Multiflexmeter/Module-V4-Pressure/docs/P22296-2-HWDOC-1.6 (Production RS485).PDF

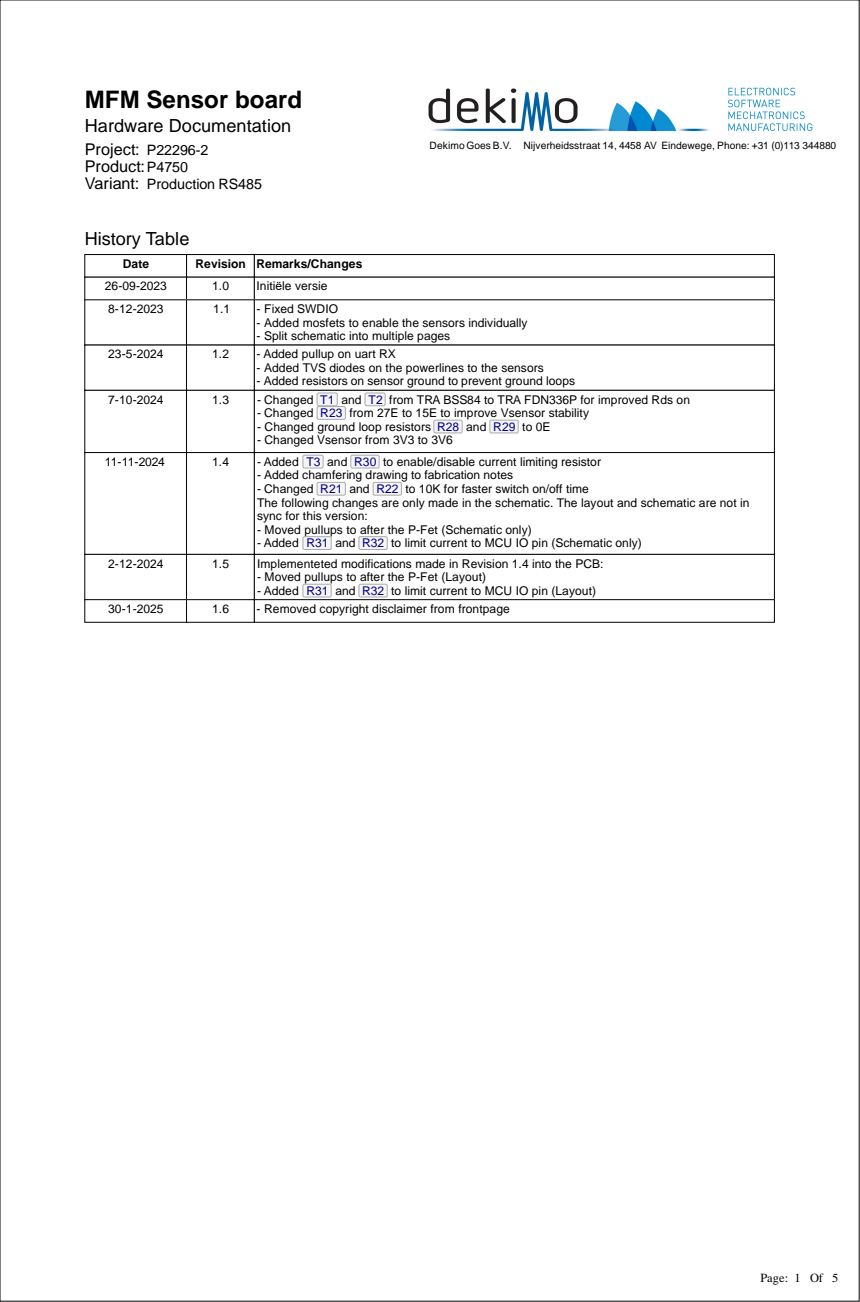
[picture p1: page 1]

Date | Revision | Remarks/Changes

26-09-2023 | 1.0 | Initiële versie

8-12-2023 | 1.1 | - Fixed SWDIO - Added mosfets to enable the sensors individually - Split schematic into multiple pages

23-5-2024 | 1.2 | - Added pullup on uart RX - Added TVS diodes on the powerlines to the sensors - Added resistors on sensor ground to prevent ground loops

7-10-2024 | 1.3 | - Changed T1 and T2 from TRA BSS84 to TRA FDN336P for improved Rds on - Changed R23 from 27E to 15E to improve Vsensor stability - Changed ground loop resistors R28 and R29 to 0E - Changed Vsensor from 3V3 to 3V6

11-11-2024 | 1.4 | - Added T3 and R30 to enable/disable current limiting resistor - Added chamfering drawing to fabrication notes - Changed R21 and R22 to 10K for faster switch on/off time The following changes are only made in the schematic. The layout and schematic are not in sync for this version: - Moved pullups to after the P-Fet (Schematic only) - Added R31 and R32 to limit current to MCU IO pin (Schematic only)

2-12-2024 | 1.5 | Implementeted modifications made in Revision 1.4 into the PCB: - Moved pullups to after the P-Fet (Layout) - Added R31 and R32 to limit current to MCU IO pin (Layout)

30-1-2025 | 1.6 | - Removed copyright disclaimer from frontpage

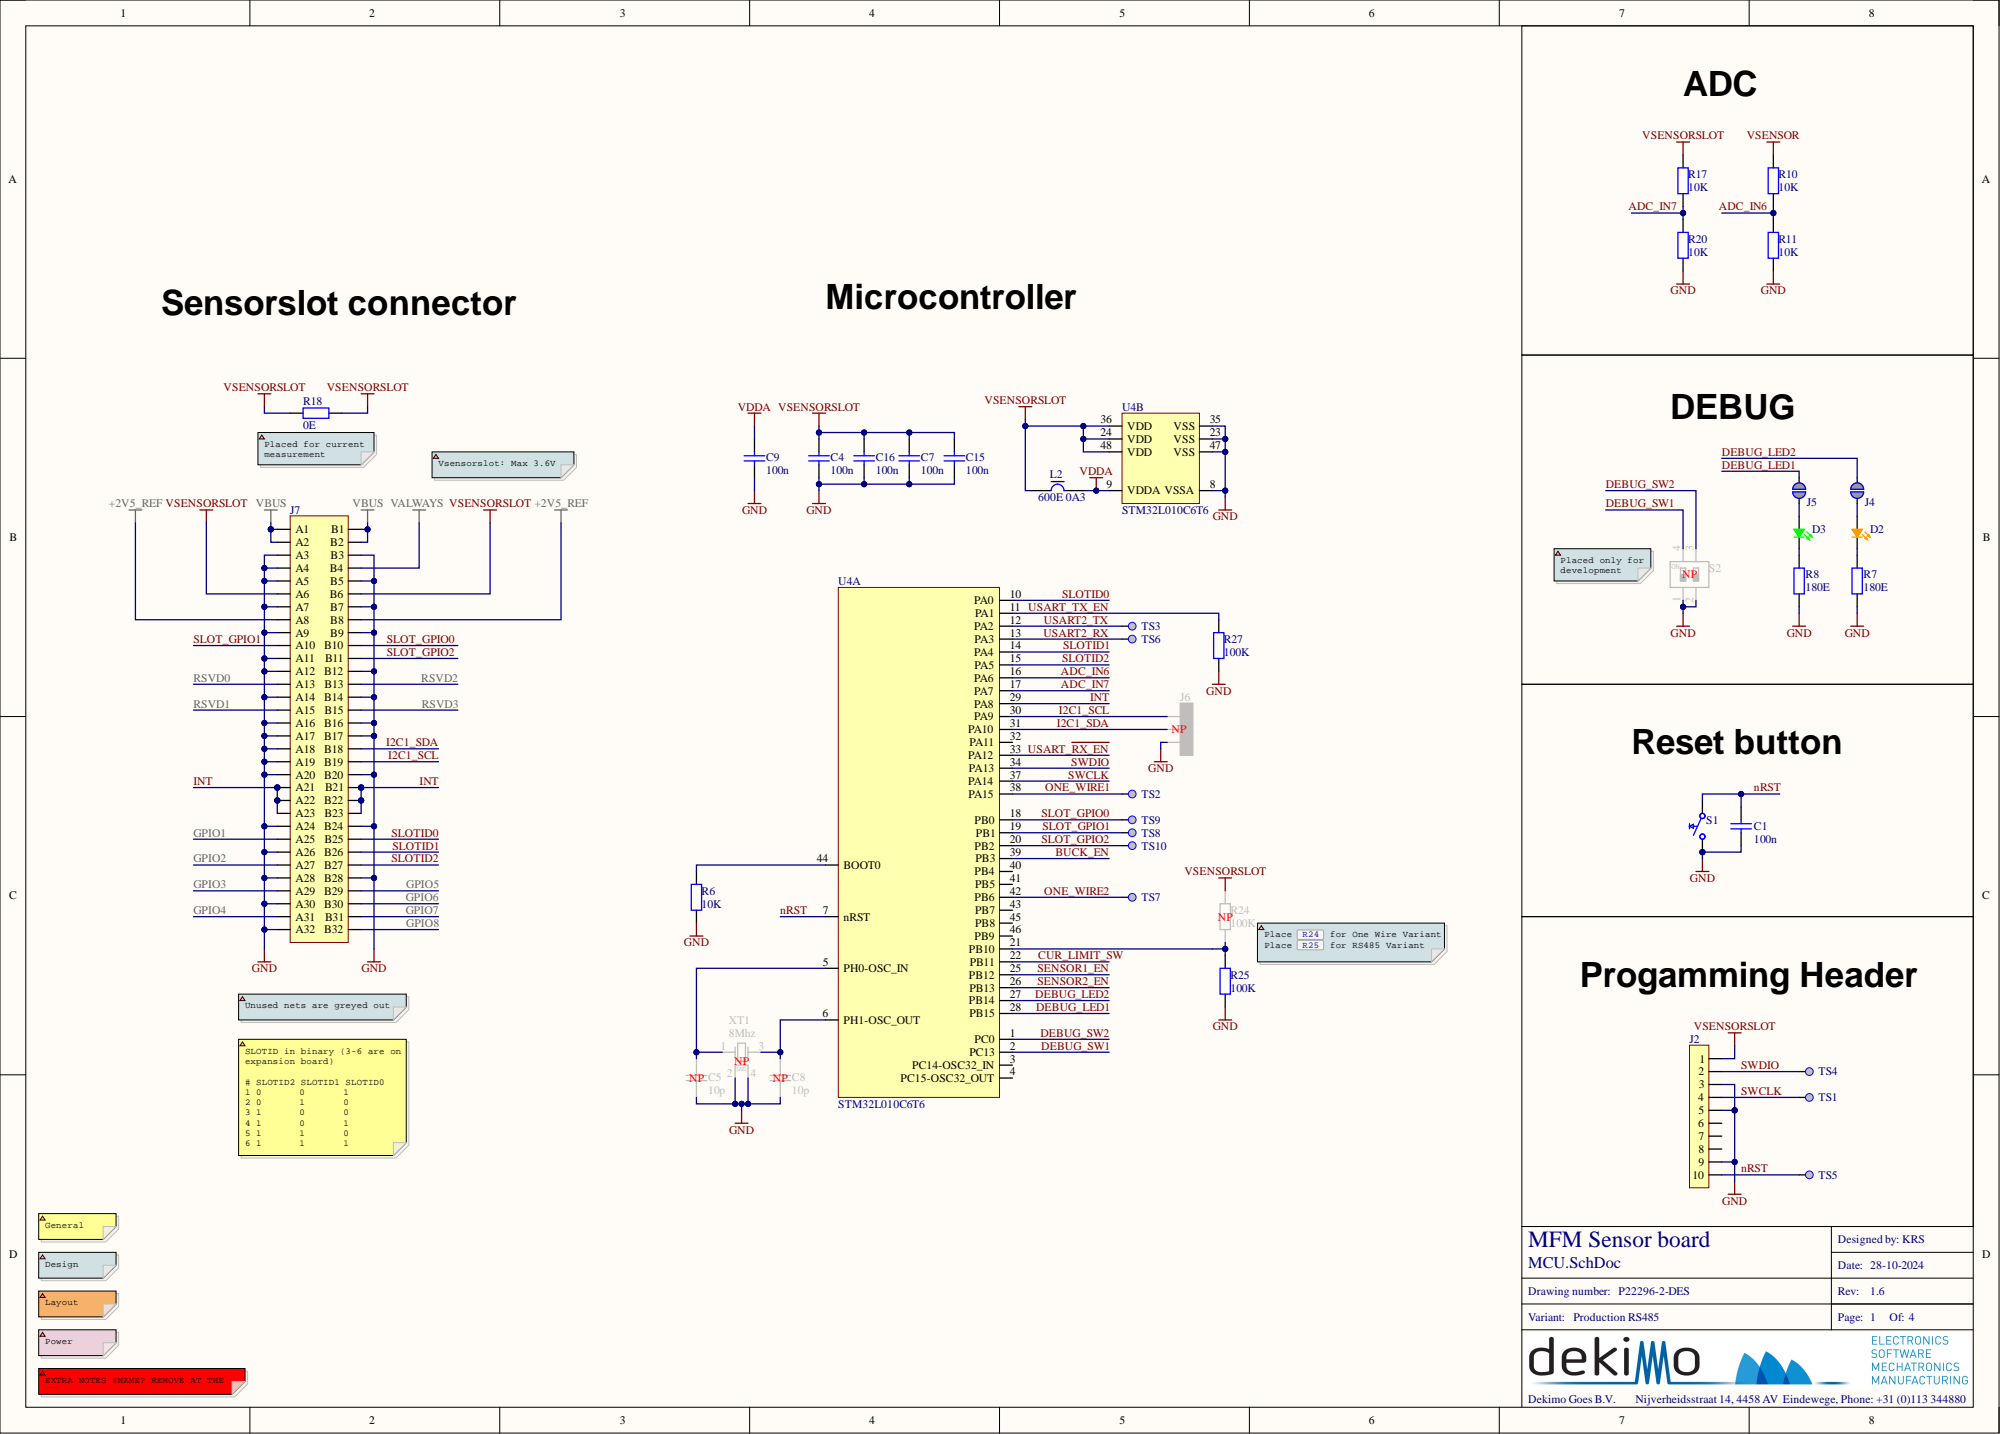
[picture p2: page 2]

2 | 4 | 2 3
4 | 8 | 4 7

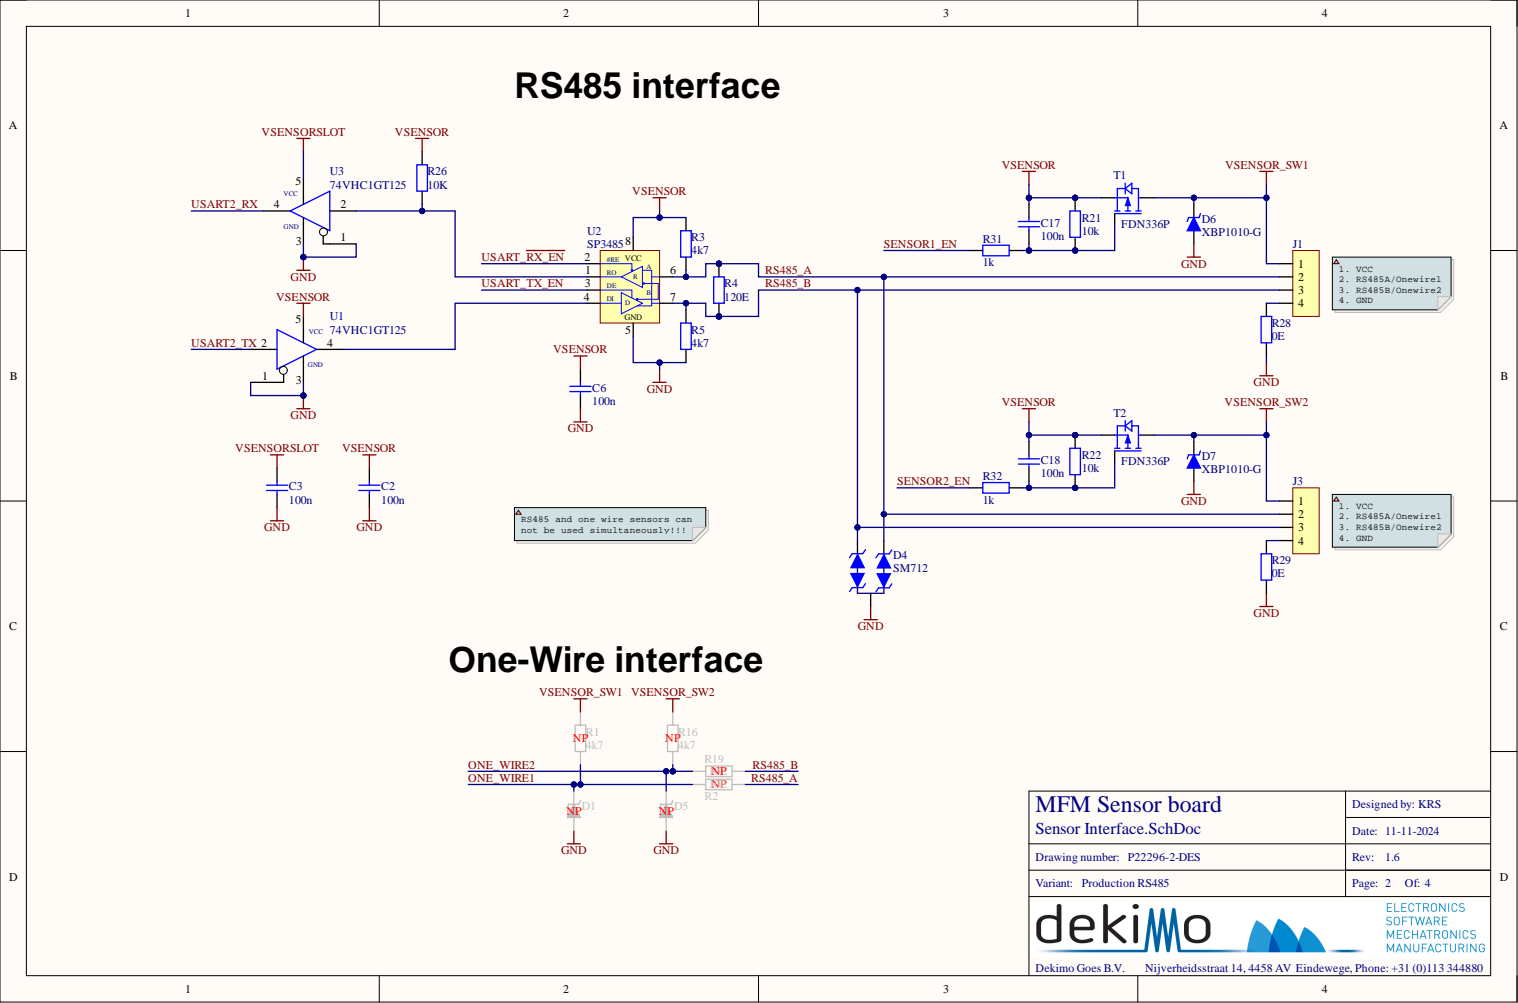
[picture p3: page 3]

RS4 8 5 _A
RS4 8 5 _B

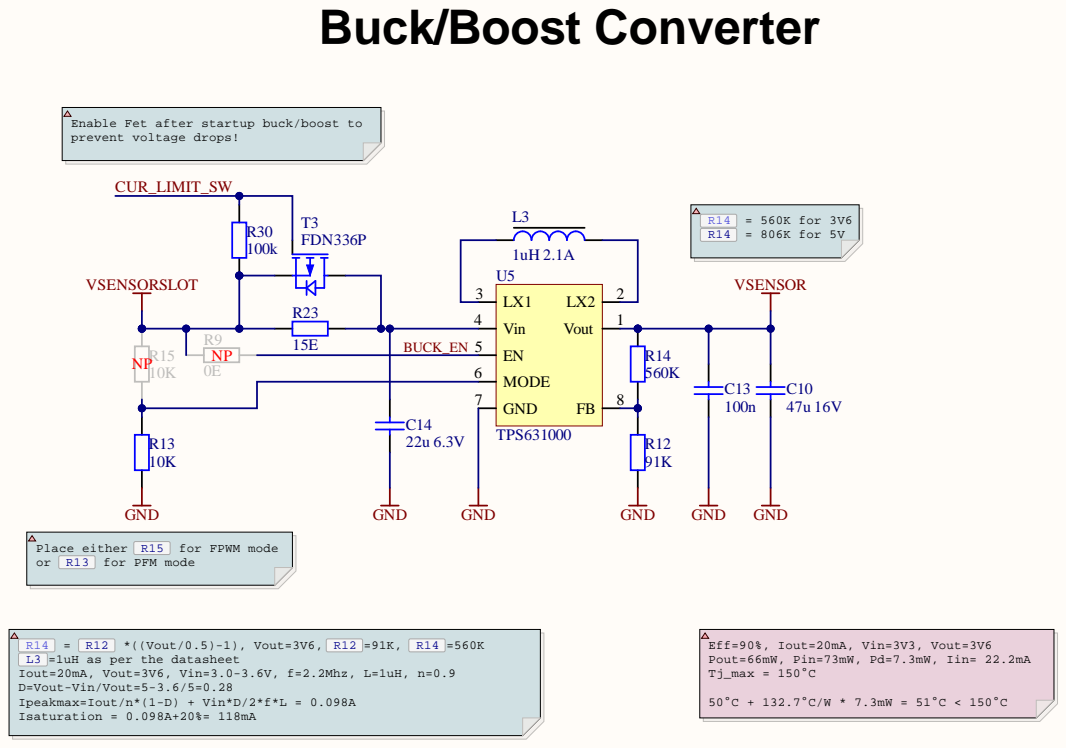
[picture p4: page 4]

Enable Fet after startup buck/boost to
prevent voltage drops!

L3 =1uH as per the datasheet
Iout=20mA, Vout=3V6, Vin=3.0-3.6V, f=2.2Mhz, L=1uH, n=0.9
D=Vout-Vin/Vout=5-3.6/5=0.28
Ipeakmax=Iout/n*(1-D) + Vin*D/2*f*L = 0.098A
Isaturation = 0.098A+20%= 118mA

Eff=90%, Iout=20mA, Vin=3V3, Vout=3V6
Pout=66mW, Pin=73mW, Pd=7.3mW, Iin= 22.2mA
Tj_max = 150°C

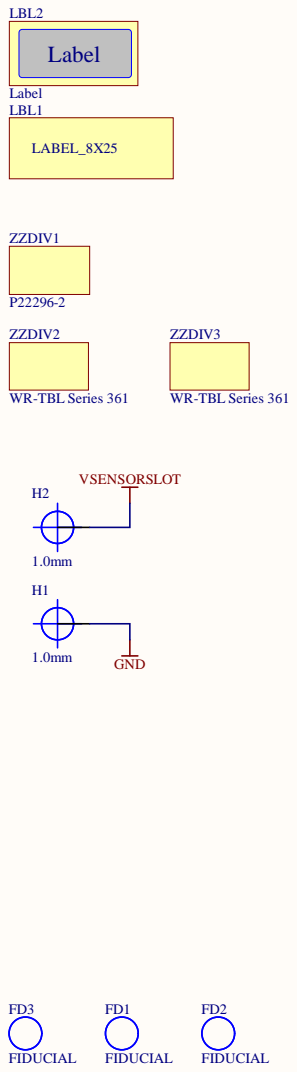
[picture p5: page 5]

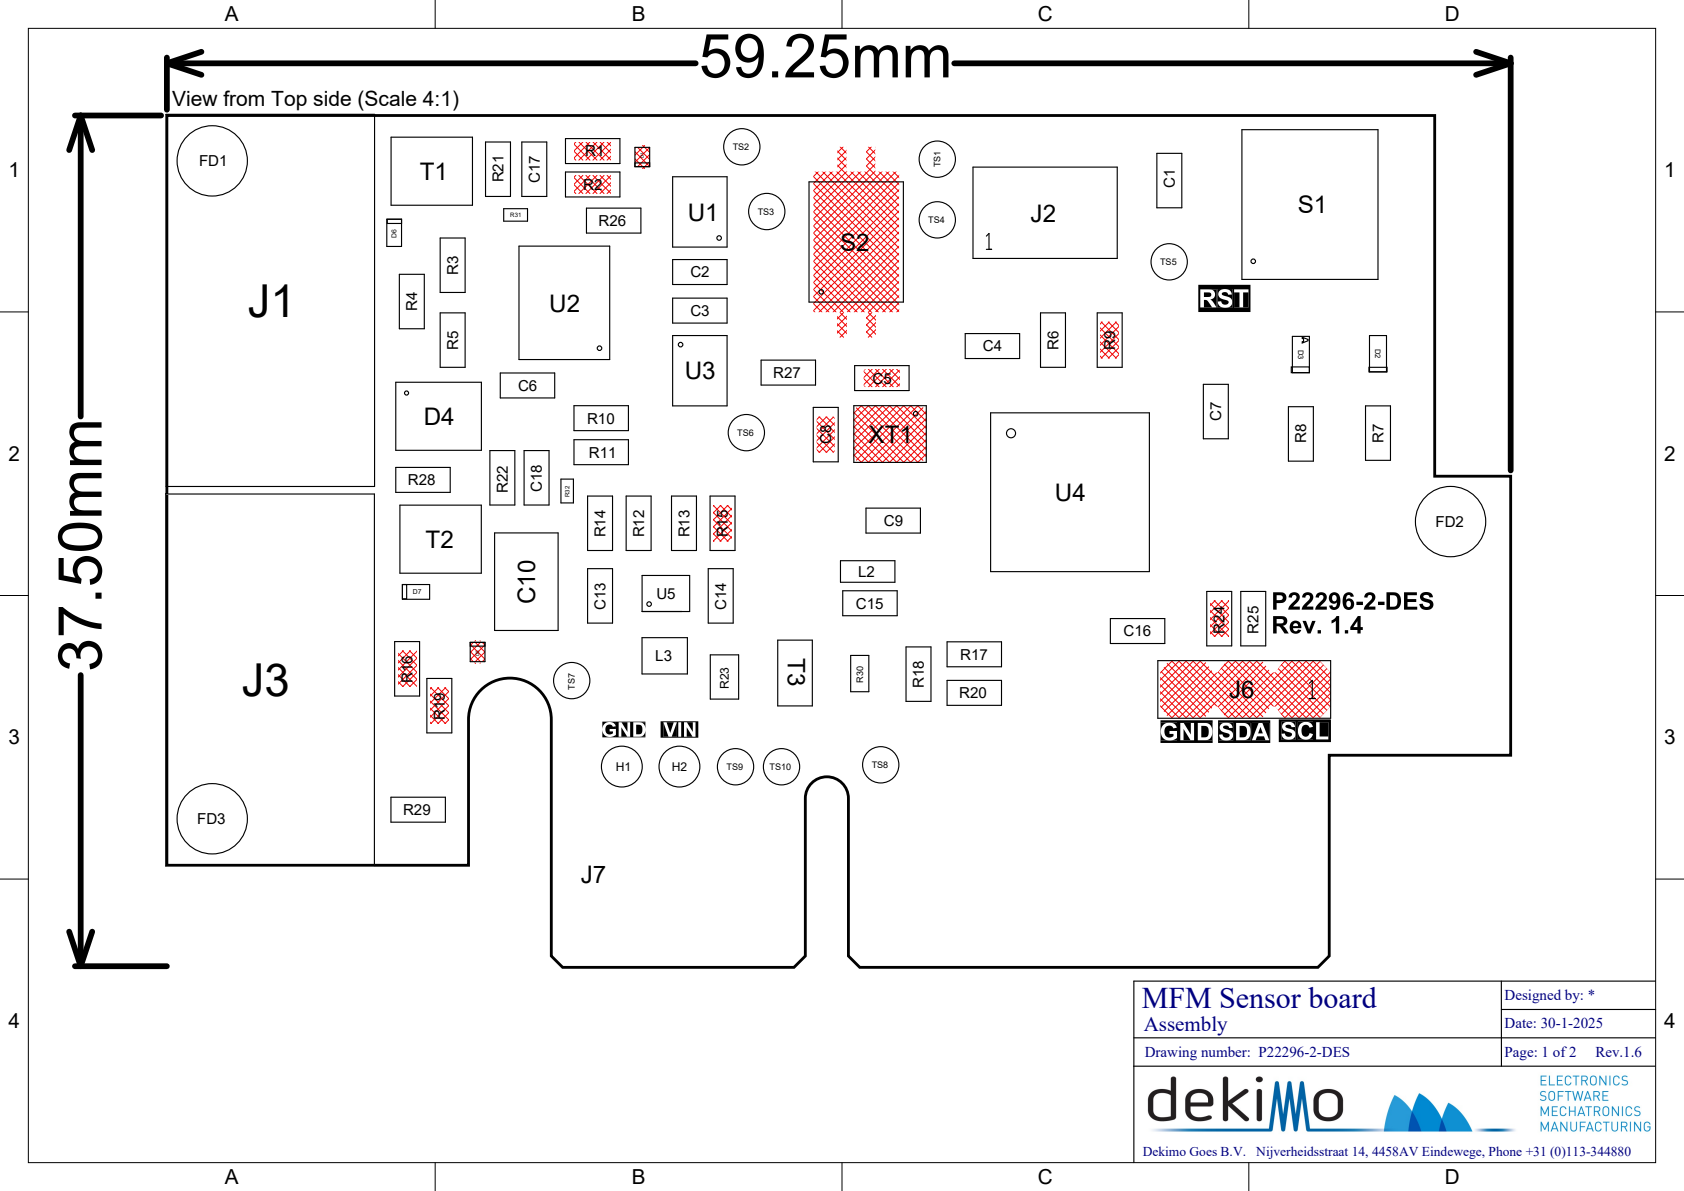
[picture p6: page 6]

View from Top side (Scale 4:1)

Dekimo Goes B.V. Nijverheidsstraat 14, 4458AV Eindewege, Phone +31 (0)113-344880

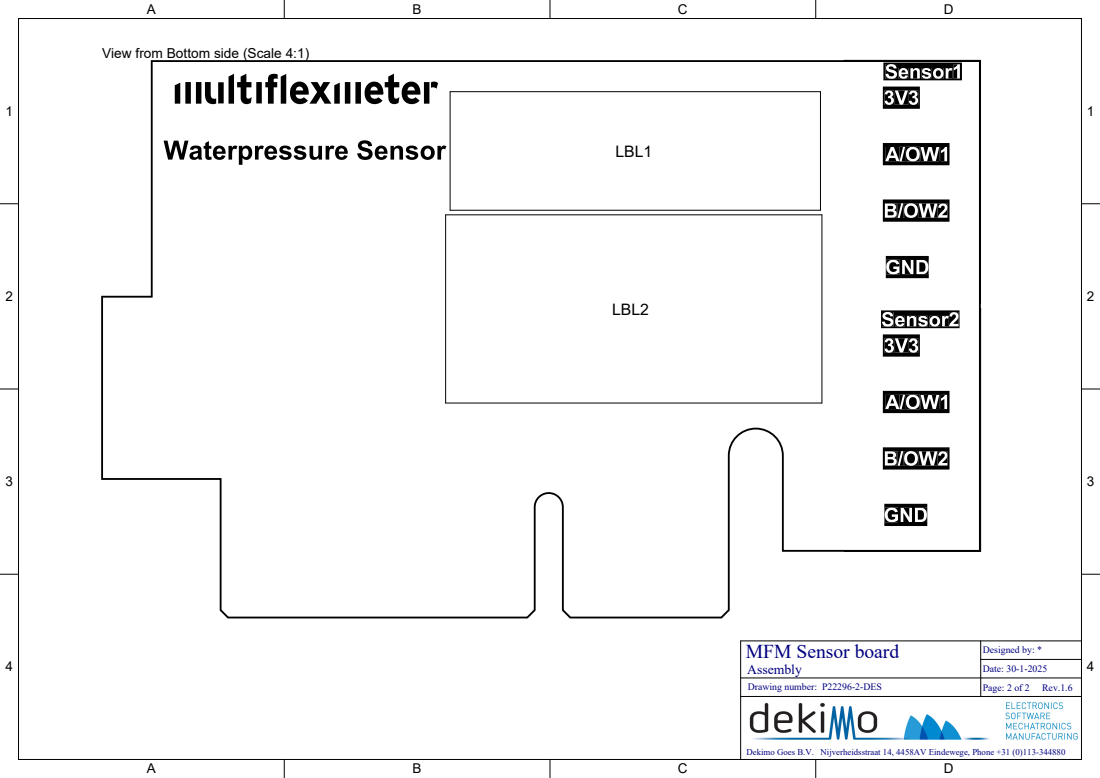
[picture p7: page 7]

View from Bottom side (Scale 4:1)

Dekimo Goes B.V. Nijverheidsstraat 14, 4458AV Eindewege, Phone +31 (0)113-344880

Partlist | Project Name: | MFM Sensor board | Product Number: P4750
Project Number: | P22296-2-DES-1.6 | Variant: | Production RS485
Designator | Amount Type | Description | Dekimo Part Code Manufacturer Part Code | Fitted | Remark
C1 | Capacitor ceramic SMD 100nF 50V 10% X7R | CKE 100N/60 | CC0603KRX7R9BB104-YAG | Fitted
C2 | Capacitor ceramic SMD 100nF 50V 10% X7R | CKE 100N/60 | CC0603KRX7R9BB104-YAG | Fitted
C3 | Capacitor ceramic SMD 100nF 50V 10% X7R | CKE 100N/60 | CC0603KRX7R9BB104-YAG | Fitted
C4 | Capacitor ceramic SMD 100nF 50V 10% X7R | CKE 100N/60 | CC0603KRX7R9BB104-YAG | Fitted
C5 | Capacitor ceramic SMD 10pF 50V 5% C0G/NP0 | CKE 10P/60 | C1608C0G1H100D080AA-TDK | Not Fitted
C6 | Capacitor ceramic SMD 100nF 50V 10% X7R | CKE 100N/60 | CC0603KRX7R9BB104-YAG | Fitted
C7 | Capacitor ceramic SMD 100nF 50V 10% X7R | CKE 100N/60 | CC0603KRX7R9BB104-YAG | Fitted
C8 | Capacitor ceramic SMD 10pF 50V 5% C0G/NP0 | CKE 10P/60 | C1608C0G1H100D080AA-TDK | Not Fitted
C9 | Capacitor ceramic SMD 100nF 50V 10% X7R | CKE 100N/60 | CC0603KRX7R9BB104-YAG | Fitted
C10 | Capacitor ceramic SMD 47uF 16V 20% X5R | CKE 47UV16/15 | EMK325BJ476MM-P-TAI | Fitted
C13 | Capacitor ceramic SMD 100nF 50V 10% X7R | CKE 100N/60 | CC0603KRX7R9BB104-YAG | Fitted
C14 | Capacitor ceramic SMD 22uF 20% 6.3V X5R | CKE 22UV6.3/60 | GRM188R60J226MEA0D-MUR | Fitted
C15 | Capacitor ceramic SMD 100nF 50V 10% X7R | CKE 100N/60 | CC0603KRX7R9BB104-YAG | Fitted
C16 | Capacitor ceramic SMD 100nF 50V 10% X7R | CKE 100N/60 | CC0603KRX7R9BB104-YAG | Fitted
C17 | Capacitor ceramic SMD 100nF 50V 10% X7R | CKE 100N/60 | CC0603KRX7R9BB104-YAG | Fitted
C18 | Capacitor ceramic SMD 100nF 50V 10% X7R | CKE 100N/60 | CC0603KRX7R9BB104-YAG | Fitted
D1 | Diode suppressor SMD TVS diode 3.3V unidirec | DIO D3V3M1U2S9 | D3V3M1U2S9-7-DIO | Not Fitted
D2 | LED SMD | Led Orange 0603 | LED SMDO/3 | 150060AS75000-WE | Fitted
D3 | LED SMD | Led Groen 0603 | LED SMDG/16 | 150060VS75003-WE | Fitted
D4 | Diode suppressor SMD 7/12V, 400W bidir. | DIO SM712 | SM712-LTL | Fitted
D5 | Diode suppressor SMD TVS diode 3.3V unidirec | DIO D3V3M1U2S9 | D3V3M1U2S9-7-DIO | Not Fitted
D6 | Diode suppressor SMD TVS Unidirectional 5V 40w | DIO XBP1010-G | XBP1010-G-TOR | Fitted
D7 | Diode suppressor SMD TVS Unidirectional 5V 40w | DIO XBP1010-G | XBP1010-G-TOR | Fitted
J1 | Plug-in term. block | PCB,BOX,RY1,PEN4,HA,P3.81 | CON PTB4/31 | 691322310004-WE | Fitted
J2 | Connector pinhdr SMD pinh 2x5/straight/Au/1.27pitch | CON PHDR2X5S/10 | M50-3600542-HAR | Fitted
J3 | Plug-in term. block | PCB,BOX,RY1,PEN4,HA,P3.81 | CON PTB4/31 | 691322310004-WE | Fitted
J6 | Connector Pinheader | pinh 1x3/straight/h=5.8/Au | CON PHDR1X3S/1 | 0-826629-3 | Not Fitted
L2 | Ferrite bead SMD | 600E @100Mhz 0.3A | IND 600E 0A3/1 | 742792653-WE | Fitted
L3 | Inductor choke SMD | Power inductor 2.1A | IND 1U 2A1/1 | 74479276210C-WE | Fitted
LBL2 | Standard Label | Multi-funct labels12.7 x25.4mm | LBL STCK/20 | - | Fitted
R1 | Resistor metalfilm SMD 4k7 100mW 1% 0603 | R 4K7/60 | RC0603FR-074K7L-YAG | Not Fitted
R2 | Resistor metalfilm SMD 10E 0.1W 1% | R 10E/60 | RC0603FR-0710RL-YAG | Not Fitted
R3 | Resistor metalfilm SMD 4k7 100mW 1% 0603 | R 4K7/60 | RC0603FR-074K7L-YAG | Fitted
R4 | Resistor metalfilm SMD 120E 0.1W 1% | R 120E/60 | RC0603FR-07120RL-YAG | Fitted

Partlist | Project Name: | MFM Sensor board | Product Number: P4750
Project Number: | P22296-2-DES-1.6 | Variant: | Production RS485
Designator | Amount Type | Description | Dekimo Part Code Manufacturer Part Code | Fitted | Remark
R5 | Resistor metalfilm SMD 4k7 100mW 1% 0603 | R 4K7/60 | RC0603FR-074K7L-YAG | Fitted
R6 | Resistor metalfilm SMD 10k 100mW, 1% | R 10K/60 | RC0603FR-0710KL-YAG | Fitted
R7 | Resistor metalfilm SMD 180E 0.1W 1% | R 180E/60 | RC0603FR-07180RL-YAG | Fitted
R8 | Resistor metalfilm SMD 180E 0.1W 1% | R 180E/60 | RC0603FR-07180RL-YAG | Fitted
R9 | Resistor metalfilm SMD 0E 100mW, 1% | R 0E/60 | RC0603FR-070RL-YAG | Not Fitted
R10 | Resistor metalfilm SMD 10k 100mW, 1% | R 10K/60 | RC0603FR-0710KL-YAG | Fitted
R11 | Resistor metalfilm SMD 10k 100mW, 1% | R 10K/60 | RC0603FR-0710KL-YAG | Fitted
R12 | Resistor metalfilm SMD 91k 0.06W 1% | R 91K/60 | RC0603FR-0791KL-YAG | Fitted
R13 | Resistor metalfilm SMD 10k 100mW, 1% | R 10K/60 | RC0603FR-0710KL-YAG | Fitted
R14 | Resistor metalfilm SMD 560kΩ 100mW 1% | R 560K/60 | RC0603FR-07560KL-YAG | Fitted
R15 | Resistor metalfilm SMD 10k 100mW, 1% | R 10K/60 | RC0603FR-0710KL-YAG | Not Fitted
R16 | Resistor metalfilm SMD 4k7 100mW 1% 0603 | R 4K7/60 | RC0603FR-074K7L-YAG | Not Fitted
R17 | Resistor metalfilm SMD 10k 100mW, 1% | R 10K/60 | RC0603FR-0710KL-YAG | Fitted
R18 | Resistor metalfilm SMD 0E 100mW, 1% | R 0E/60 | RC0603FR-070RL-YAG | Fitted
R19 | Resistor metalfilm SMD 10E 0.1W 1% | R 10E/60 | RC0603FR-0710RL-YAG | Not Fitted
R20 | Resistor metalfilm SMD 10k 100mW, 1% | R 10K/60 | RC0603FR-0710KL-YAG | Fitted
R21 | Resistor metalfilm SMD 10kΩ 100mW 1% | R 10K/60 | RC0603FR-0710KL-YAG | Fitted
R22 | Resistor metalfilm SMD 10kΩ 100mW 1% | R 10K/60 | RC0603FR-0710KL-YAG | Fitted
R23 | Resistor metalfilm SMD 15Ω 125mW 1% | R 15E/11 | RC0805FR-0715RL-YAG | Fitted
R24 | Resistor metalfilm SMD 100k 100mW, 1% | R 100K/60 | CRG0603F100K-TEC | Not Fitted
R25 | Resistor metalfilm SMD 100k 100mW, 1% | R 100K/60 | CRG0603F100K-TEC | Fitted
R26 | Resistor metalfilm SMD 10k 100mW, 1% | R 10K/60 | RC0603FR-0710KL-YAG | Fitted
R27 | Resistor metalfilm SMD 100k 100mW, 1% | R 100K/60 | CRG0603F100K-TEC | Fitted
R28 | Resistor metalfilm SMD 0Ω 100mW 1% | R 0E/60 | RC0603FR-070RL-YAG | Fitted
R29 | Resistor metalfilm SMD 0Ω 100mW 1% | R 0E/60 | RC0603FR-070RL-YAG | Fitted
R30 | Resistor metalfilm SMD 100kΩ 100mW 1% | R 100K/60 | CRG0603F100K-TEC | Fitted
R31 | Resistor metalfilm SMD 1kΩ 62.5mW 1% | R 1K/70 | RC0402FR-071KL-YAG | Fitted
R32 | Resistor metalfilm SMD 1kΩ 62.5mW 1% | R 1K/70 | RC0402FR-071KL-YAG | Fitted
S1 | Switch push button SMD PCB SPNO 6x6.6mm, h=4,3mm refl SW PBSPNO/25 | B3S-1000P-OMR | Fitted
S2 | Switch slide SMD | DIP,2p,Straight,H=2,3mm,SMD,AU SW DIP2SO/G2 | GDH02S04-TYC | Not Fitted
T1 | FET P-channel SMD | 20V 1.3A 200mΩ logic level | TRA FDN336P | FDN336P-FCH | Fitted
T2 | FET P-channel SMD | 20V 1.3A 200mΩ logic level | TRA FDN336P | FDN336P-FCH | Fitted
T3 | FET P-channel SMD | 20V 1.3A 200mΩ logic level | TRA FDN336P | FDN336P-FCH | Fitted
U1 | IC interface SMD | buffer/ levelshifter | IC 74VHC1GT125 | M74VHC1GT125DT1G-ONS | Fitted

Partlist | Project Name: | MFM Sensor board | Product Number: P4750
Project Number: | P22296-2-DES-1.6 | Variant: | Production RS485
Designator | Amount Type | Description | Dekimo Part Code Manufacturer Part Code | Fitted | Remark
U2 | IC interface SMD | RS485/RS422, 3v3, 10Mbps | IC MAX3485/ETSO | SP3485EN-L-SIP | Fitted
U3 | IC interface SMD | buffer/ levelshifter | IC 74VHC1GT125 | M74VHC1GT125DT1G-ONS | Fitted
U4 | IC microcontroller SMD STM32L010C6T6 | IC STM32L010C6T | STM32L010C6T6-STM | Fitted
U5 | IC regulator SMD | Buck/boost 1.5-5.5V, 1A5 | IC TPS631000 | TPS631000DRLR-TI | Fitted
XT1 | Quarz crystal SMD | 8 MHz, 10%, 30ppm | XT 8MHZ/1 | ECS-80-10-33-CGN-TR3-ECS | Not Fitted
ZZDIV1 | $PCB | MFM Sensor(druk) | PCB P22296-2 | P22296-2 | Fitted
ZZDIV2 | Plug terminal block | Screw,4p,Fem,P3.81,Straight | CON STB4F/32 WE | 691361300004-WE | Fitted
ZZDIV3 | Plug terminal block | Screw,4p,Fem,P3.81,Straight | CON STB4F/32 WE | 691361300004-WE | Fitted
