Multiflexmeter/Module-V4-Pressure/(list of files, drawings)

Other design files:
hardware/Frontpage.SchDoc
hardware/MCU.SchDoc
hardware/Mechanical.SchDoc
hardware/P22296-2-DES.PrjPcb
hardware/Power.SchDoc
hardware/Sensor Interface.SchDoc
