Multiflexmeter/Module-V4-Pressure/Core/Src/main.c

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
/* Includes ------------------------------------------------------------------*/
#include "main.h"

/* USER CODE BEGIN Includes */
#include <stdbool.h>
#include <stdio.h>
#include <string.h>
#include "SensorRegister.h"
#include "I2C_Slave.h"
#include "modbus.h"
#include "adc.h"
#include "utils.h"
/* USER CODE END Includes */

/* USER CODE BEGIN PTD */
/**
 * @enum  state_machine_t
 * @brief different states
 *
 */
typedef enum
{
  POLL_RS485_SENSOR,  /**< POLL_RS485_SENSOR */
  POLL_ONEWIRE_SENSOR,/**< POLL_ONEWIRE_SENSOR */
  WRITE_REGISTER,     /**< WRITE_REGISTER */
  ASSIGN_ADDRESS,     /**< ASSIGN_ADDRESS */
  SLEEP,              /**< SLEEP */
} state_machine_t;
/* USER CODE END PTD */

ADC_HandleTypeDef hadc;

I2C_HandleTypeDef hi2c1;

TIM_HandleTypeDef htim2;
TIM_HandleTypeDef htim21;

UART_HandleTypeDef huart2;
DMA_HandleTypeDef hdma_usart2_rx;
DMA_HandleTypeDef hdma_usart2_tx;

/* USER CODE BEGIN PV */
extern uint16_t supplyVSENSOR;
extern uint16_t supplyVSENSORSLOT;

state_machine_t currentState = SLEEP;
variant_t variant;
uint16_t samples;

/* USER CODE END PV */

void SystemClock_Config(void);
static void MX_GPIO_Init(void);
static void MX_DMA_Init(void);
static void MX_ADC_Init(void);
static void MX_I2C1_Init(void);
static void MX_USART2_UART_Init(void);
static void MX_TIM2_Init(void);
static void MX_TIM21_Init(void);
/* USER CODE BEGIN PFP */
void OneWireSystemClock_Config(void);
/* USER CODE END PFP */

/**
  * @brief  The application entry point.
  * @retval int
  */
int main(void)
{
  /* MCU Configuration--------------------------------------------------------*/

  /* Reset of all peripherals, Initializes the Flash interface and the Systick. */
  HAL_Init();

  /* USER CODE BEGIN SysInit */
  MX_GPIO_Init();
  variant = getVariant();
  /* Configure the system clock */
  if(variant == ONEWIRE_VARIANT)
  {
    OneWireSystemClock_Config();
    setSensorType(MFM_DRUKMODULE_ONEWIRE);
    setMeasureTime(DEF_MEAS_TIME_ONEWIRE);
    setMeasureDataSize(MFM_DRUKMODULE_ONEWIRE);
  }

  else if(variant == RS485_VARIANT)
  {
    SystemClock_Config();
    setSensorType(MFM_DRUKMODULE_RS485);
    enableInitFunction(); //enable the sensor init function
    setMeasureTime(DEF_MEAS_TIME_RS485);
    setMeasureDataSize(MFM_DRUKMODULE_RS485);
  }
  /* USER CODE END SysInit */

  /* Initialize all configured peripherals */
  MX_GPIO_Init();
  MX_DMA_Init();
  MX_ADC_Init();
  MX_I2C1_Init();
  MX_USART2_UART_Init();
  MX_TIM2_Init();
  MX_TIM21_Init();
  /* USER CODE BEGIN 2 */
  ModbusInit(&huart2);
  HAL_I2C_EnableListen_IT(&hi2c1);
  setSlaveAddress();

  // Check the sensorslot power supply voltage
  supplyVSENSORSLOT = ADC_Vsensorslot_Measure(&hadc);
  if(supplyVSENSORSLOT <= 2700 || supplyVSENSORSLOT >= 3800)
    setErrorCode(VCC_ERROR);
  /* USER CODE END 2 */

  /* Infinite loop */
  /* USER CODE BEGIN WHILE */
  while (1)
  {
    switch (currentState)
    {
      case POLL_RS485_SENSOR:
        /* Measure the RS485 Sensor */
        measureKellerSensor();

        /* Finish measurement */
        currentState = SLEEP;
        break;

      case POLL_ONEWIRE_SENSOR:
        /* Measure the OneWire Sensor */
        measureHubaSensor();

        /* Finish measurement */
        currentState = SLEEP;
        break;

      case WRITE_REGISTER:
        if (regWriteData[0] == REG_SENSOR_SELECTED)
        {
          writeRegister(regWriteData, regSize + 3);
          storeSelectedSensor(regWriteData[1]);
        }
        else
          writeRegister(regWriteData, regSize + 3);

        writeFlag = false;
        currentState = SLEEP;
        break;

      case ASSIGN_ADDRESS:
        {
          bool result = true;
          if (variant == RS485_VARIANT)
          {
            result = assignAddressKeller(getSelectedSensor());
          }
          setInitStatusReady(result);
          currentState = SLEEP;
        }
        break;

      case SLEEP:

        //check if a write flag is found
        if (writeFlag)
        {
          currentState = WRITE_REGISTER;
        }

        //check if a sensor init command is received
        else if( getInitStartStatus())
        {
          setInitStatusBusy();
          currentState = ASSIGN_ADDRESS;
        }

        // If the measurement start register has been set to 1
        else if(readMeasStart())
        {
          setMeasurementStatus(MEASUREMENT_ACTIVE);
          samples = readMeasSamples();

          /* Check which sensor type to poll */
          if (variant == RS485_VARIANT)
          {
            switchOnSensor_BothKeller(); //switch on timed buck converter and sensor1 + sensor2

            currentState = POLL_RS485_SENSOR;
            HAL_Delay(25); //todo remove, now 10ms at switch on + 25 = 35ms same as before
          }
          else if (variant == ONEWIRE_VARIANT)
          {
            controlBuckConverter( GPIO_PIN_SET); //enable buck converter
            HAL_Delay(25); //wait for stabilized supply. Needs to be 25ms minimum for guaranteeing stable output voltage.
            disableCurrentLimit();
            currentState = POLL_ONEWIRE_SENSOR;
          }
        }

        break;
    }

    //check sensorSlave error is active and restart the I2C.
    if( sensorSlaveErrorFlag )
    {
      sensorSlaveErrorFlag = false;

      HAL_I2C_DeInit(&hi2c1);

      MX_I2C1_Init();
      HAL_I2C_EnableListen_IT(&hi2c1);
      setSlaveAddress();
      setErrorCode(I2C_ERROR);
    }

    /* USER CODE END WHILE */

    /* USER CODE BEGIN 3 */
  }
  /* USER CODE END 3 */
}

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
/* USER CODE BEGIN 4 */
void OneWireSystemClock_Config(void)
{
  RCC_OscInitTypeDef RCC_OscInitStruct = {0};
  RCC_ClkInitTypeDef RCC_ClkInitStruct = {0};
  RCC_PeriphCLKInitTypeDef PeriphClkInit = {0};

  /** Configure the main internal regulator output voltage
  */
  __HAL_PWR_VOLTAGESCALING_CONFIG(PWR_REGULATOR_VOLTAGE_SCALE1);

  /** Initializes the RCC Oscillators according to the specified parameters
  * in the RCC_OscInitTypeDef structure.
  */
  RCC_OscInitStruct.OscillatorType = RCC_OSCILLATORTYPE_HSI;
  RCC_OscInitStruct.HSIState = RCC_HSI_ON;
  RCC_OscInitStruct.HSICalibrationValue = RCC_HSICALIBRATION_DEFAULT;
  RCC_OscInitStruct.PLL.PLLState = RCC_PLL_ON;
  RCC_OscInitStruct.PLL.PLLSource = RCC_PLLSOURCE_HSI;
  RCC_OscInitStruct.PLL.PLLMUL = RCC_PLLMUL_4;
  RCC_OscInitStruct.PLL.PLLDIV = RCC_PLLDIV_2;
  if (HAL_RCC_OscConfig(&RCC_OscInitStruct) != HAL_OK)
  {
    Error_Handler();
  }

  /** Initializes the CPU, AHB and APB buses clocks
  */
  RCC_ClkInitStruct.ClockType = RCC_CLOCKTYPE_HCLK|RCC_CLOCKTYPE_SYSCLK
                              |RCC_CLOCKTYPE_PCLK1|RCC_CLOCKTYPE_PCLK2;
  RCC_ClkInitStruct.SYSCLKSource = RCC_SYSCLKSOURCE_PLLCLK;
  RCC_ClkInitStruct.AHBCLKDivider = RCC_SYSCLK_DIV1;
  RCC_ClkInitStruct.APB1CLKDivider = RCC_HCLK_DIV2;
  RCC_ClkInitStruct.APB2CLKDivider = RCC_HCLK_DIV2;

  if (HAL_RCC_ClockConfig(&RCC_ClkInitStruct, FLASH_LATENCY_1) != HAL_OK)
  {
    Error_Handler();
  }
  PeriphClkInit.PeriphClockSelection = RCC_PERIPHCLK_USART2|RCC_PERIPHCLK_I2C1;
  PeriphClkInit.Usart2ClockSelection = RCC_USART2CLKSOURCE_HSI;
  PeriphClkInit.I2c1ClockSelection = RCC_I2C1CLKSOURCE_HSI;
  if (HAL_RCCEx_PeriphCLKConfig(&PeriphClkInit) != HAL_OK)
  {
    Error_Handler();
  }
  HAL_RCC_MCOConfig(RCC_MCO1, RCC_MCO1SOURCE_HSI, RCC_MCODIV_1);
}
/* USER CODE END 4 */
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
