Multiflexmeter/Module-V4-Pressure/Core/Inc/main.h

#define DEBUG_SW2_Pin GPIO_PIN_0
#define DEBUG_SW2_GPIO_Port GPIOC
#define DEBUG_SW1_Pin GPIO_PIN_13
#define DEBUG_SW1_GPIO_Port GPIOC
#define SLOTID0_Pin GPIO_PIN_0
#define SLOTID0_GPIO_Port GPIOA
#define USART_TX_EN_Pin GPIO_PIN_1
#define USART_TX_EN_GPIO_Port GPIOA
#define SLOTID1_Pin GPIO_PIN_4
#define SLOTID1_GPIO_Port GPIOA
#define SLOTID2_Pin GPIO_PIN_5
#define SLOTID2_GPIO_Port GPIOA
#define SLOT_GPIO0_Pin GPIO_PIN_0
#define SLOT_GPIO0_GPIO_Port GPIOB
#define SLOT_GPIO1_Pin GPIO_PIN_1
#define SLOT_GPIO1_GPIO_Port GPIOB
#define SLOT_GPIO2_Pin GPIO_PIN_2
#define SLOT_GPIO2_GPIO_Port GPIOB
#define VARIANT_DETECT_Pin GPIO_PIN_10
#define VARIANT_DETECT_GPIO_Port GPIOB
#define CURRENT_SW_Pin GPIO_PIN_11
#define CURRENT_SW_GPIO_Port GPIOB
#define SENSOR1_EN_Pin GPIO_PIN_12
#define SENSOR1_EN_GPIO_Port GPIOB
#define SENSOR2_EN_Pin GPIO_PIN_13
#define SENSOR2_EN_GPIO_Port GPIOB
#define DEBUG_LED2_Pin GPIO_PIN_14
#define DEBUG_LED2_GPIO_Port GPIOB
#define DEBUG_LED1_Pin GPIO_PIN_15
#define DEBUG_LED1_GPIO_Port GPIOB
#define INT_Pin GPIO_PIN_8
#define INT_GPIO_Port GPIOA
#define USART_RX_EN_Pin GPIO_PIN_12
#define USART_RX_EN_GPIO_Port GPIOA
#define ONE_WIRE1_Pin GPIO_PIN_15
#define ONE_WIRE1_GPIO_Port GPIOA
#define BUCK_EN_Pin GPIO_PIN_3
#define BUCK_EN_GPIO_Port GPIOB
#define ONE_WIRE2_Pin GPIO_PIN_6
#define ONE_WIRE2_GPIO_Port GPIOB
