Multiflexmeter/Module-V4-Pressure/App/SensorRegister.h

#ifndef SENSORREGISTER_H_
#define SENSORREGISTER_H_

/* Sensor Registers */
#define REG_FIRMWARE_VERSION      0x01
#define REG_PROTOCOL_VERSION      0x02
#define REG_SENSOR_TYPE           0x03
#define REG_MEAS_START            0x10
#define REG_MEAS_STATUS           0x11
#define REG_MEAS_TIME             0x12
#define REG_MEAS_SIZE             0x20
#define REG_MEAS_DATA             0x21
#define REG_SENSOR_AMOUNT         0x30
#define REG_SENSOR_SELECTED       0x31
#define REG_MEAS_TYPE             0x32
#define REG_MEAS_SAMPLES          0x33
#define REG_SENSOR_UNIT           0x37
#define REG_SENSOR_SIZE           0x38
#define REG_SENSOR_DATA           0x39
#define REG_ERROR_COUNT           0x50
#define REG_ERROR_STATUS          0x51

/* Registers Defaults*/
#define DEF_FIRMWARE_VERSION  "0t4.y"
#define DEF_PROTOCOL_VERSION  0x00
#define DEF_SENSOR_TYPE       0x01
#define DEF_MEAS_START        0x00
#define DEF_MEAS_STATUS       0x00
#define DEF_MEAS_TIME         0x0064
#define DEF_MEAS_SIZE         0x04
#define DEF_MEAS_DATA         0xFFFF
#define DEF_SENSOR_AMOUNT     0x02
#define DEF_SENSOR_SELECTED   0x00
#define DEF_MEAS_TYPE         0x00
#define DEF_MEAS_SAMPLES      0x000A
#define DEF_SENSOR_UNIT       0x02
#define DEF_SENSOR_SIZE       0x02
#define DEF_SENSOR_DATA       0xFFFF
#define DEF_ERROR_COUNT       0x0000
#define DEF_ERROR_STATUS      0

/* Typedefs */
typedef enum{
  UINT8_T = 1,
  UINT16_T = 2
}tENUM_Datatype;

typedef enum{
  NO_ERROR,
  CRC_ERROR,
  ADDRESS_ERROR,
  WRITE_ERROR
}tENUM_Error;

typedef enum{
  READ,
  READWRITE
}tENUM_READWRITE;

typedef struct
{
  uint8_t adres;
  void *regPtr;
  tENUM_Datatype datatype;
  uint8_t size;
  tENUM_READWRITE RW;
}SensorReg;

extern const SensorReg registers[];
/* Functions */
int8_t findRegIndex(uint8_t regAddress);
void writeRegister(uint8_t *data);
//void readRegister(uint8_t *data, size_t lenght);


#endif /* SENSORREGISTER_H_ */
