Multiflexmeter/Module-V4-Pressure/App/Keller/Keller.h

/**
  ******************************************************************************
  * @file           Keller.h
  * @brief          header for Keller.c
  * @author         D.Kerstens
  ******************************************************************************
  */

#include <stdbool.h>
#include "modbus.h"
#include "SensorRegister.h"

#ifndef KELLER_KELLERMODBUS_H_
#define KELLER_KELLERMODBUS_H_

/* Modbus Addresses */
#define BROADCAST_ADDRESS         0x00
#define DEFAULT_ADDRESS           0x01

/* Keller Functions */
typedef enum
{
  FunctionReadCoefficients =      30,
  FunctionWriteCoefficients =     31,
  FunctionReadConfigurations =    32,
  FunctionWriteConfigurations =   33,
  FunctionInitialiseDevices =     48,
  FunctionWriteDeviceAddress =    66,
  FunctionReadSerialNumber =      69,
  FunctionReadChannelFloat =      73,
  FunctionReadShannelInt =        74,
  FunctionZeroing =               95,
}Keller_Function_t;

/* Keller Configurations */
typedef enum
{
  CONFIG_CFG_P =                  0,
  CONFIG_CFG_T =                  1,
  CONFIG_CFG_CH0 =                2,
  CONFIG_CNT_T =                  3,
  CONFIG_CNT_TCOMP =              4,
  CONFIG_FILTER =                 7,
  CONFIG_DAC =                    9,
  CONFIG_UART =                   10,
  CONFIG_FILTER_BCK =             11,
  CONFIG_STAT =                   12,
  CONFIG_DEV_ADDR =               13,
  CONFIG_P_MODE =                 14,
  CONFIG_SPS =                    15,
  CONFIG_SDI_12 =                 20,
  CONFIG_FRAME_TIME_9K6 =         25,
  CONFIG_FRAME_TIME_115K2 =       26,
  CONFIG_CON_ON =                 28,
  CONFIG_CON_RANGE =              31,
  CONFIG_CON_COMP_MODE =          32,
  CONFIG_SDI_12_AVAILABLE =       33,
}Keller_Configurations_t;

/* Keller Channels */
typedef enum
{
  CHANNEL_P1 =                    1,
  CHANNEL_P2 =                    2,
  CHANNEL_T =                     3,
  CHANNEL_TOB1 =                  4,
  CHANNEL_TOB2 =                  5,
  CHANNEL_CONTC =                 10,
  CHANNEL_CONRAW =                11,
}Keller_Channel_t;

/* Keller Channels */
typedef enum
{
  BAUD_9600 =                      0,
  BAUD_115200 =                    1,
}Keller_Baudrate_t;


#define READ_COEFFICIENTS         0x1E  //F30: Read coefficients
#define WRITE_COEFFICIENTS        0x1F  //F31: Write coefficients
#define READ_CONFIGURATION        0x20  //F32: Read configuration
#define WRITE_CONFIGURATION       0x21  //F33: Write configuration
#define INITIALIZE                0x30  //F48: Initialize and release
#define NEW_ADDRESS               0x42  //F66: Write and read new device address
#define READ_SERIALNUMBER         0x45  //F69: Read the serial number
#define READ_CHANNEL_FLOAT        0x49  //F73: Read value of a channel float
#define READ_CHANNEL_LONG         0x4A  //F74: Read value of a channel 32bit integer

/* Keller Errors */
#define INITIALISATION_ERROR      0x20

/* Keller Registers */
#define CALCULATED_VALUE          0x0000
#define PRESSURE_SENSOR1          0x0002
#define PRESSURE_SENSOR2          0x0004
#define TEMPERATURE               0x0006
#define TEMPERATURE_SENSOR1       0x0008
#define TEMPERATURE_SENSOR2       0x000A
#define UART_CONFIGURATION        0x0200


/* Keller Functions */
bool KellerInit(uint8_t slaveAddress);
uint32_t KellerSerialnumber(uint8_t slaveAddress);
bool KellerSetBaudrate(uint8_t slaveAddress, uint8_t baudrate);
bool KellerCheckBaudrate(uint8_t slaveAddress, Keller_Baudrate_t baudrate);
uint8_t KellerNewAddress(uint8_t currentSlaveAddress, uint8_t newSlaveAddress);

int32_t KellerReadPressure(uint8_t slaveAddress);
int32_t KellerReadTemperature(uint8_t slaveAddress);
SensorData KellerReadTempAndPressure(uint8_t slaveAddress);

#endif /* KELLER_KELLERMODBUS_H_ */
