Multiflexmeter/Module-V4-Pressure/App/i2cSlave/Inc/crc16.h

/**
  ******************************************************************************
  * @file           crc16.h
  * @brief          header for crc16.c
  * @author         D.Kerstens
  ******************************************************************************
  */
#ifndef CRC16_TABLE_H
#define CRC16_TABLE_H

#include <stdint.h>

#define CRC16INITVALUE  0xFFFF  //Initial CRC value

uint16_t calculateCRC_CCITT(uint8_t * data, int length);

#endif
