Multiflexmeter/Module-V4-Pressure/(commit log)

2023-07-11 Add: added i2c slave code files
2023-07-13 Add: added register dependant size for the i2c messages and a transmit function for the read commands
2023-08-09 Refactor: Change crcSize to CRC_SIZE. Added extra comments to the i2c handling
2023-09-05 Add: add source and header files for the keller sensor
2023-09-21 Add: added first test with the echo of the keller sensor
2023-09-25 Add: added timer for delay us function and timer for one wire decoding
2023-09-25 Add: added source files for the huba sensor
2023-09-25 Change: enabled interrupts and added debug io
2023-09-26 Add: store the raw data in the sensor register
2023-09-26 Add: added median calculation of selected amount of samples
2023-09-26 Add: start sensor enable from the register measurment start
2023-09-26 Change: moved echo function to keller because it is specific for the keller sensor.
2023-09-27 Add: add function to change the device address of the sensor
2023-09-28 Add: add function to read the pressure and temperature
2023-09-29 Change: Test with timer interrupt
2023-10-06 Add: added second timer
2023-10-06 Change: Migrate P22296-2-SW from the development kit to STM32L010C6T6
2023-10-06 Fixed merge conflicts and regenerated project
    [main.c, main.h]
2023-10-06 Change: Enabled dma for ADC
2023-10-06 Add: generated files due to enabling the DMA
2023-10-06 Add: added calculation of Vsensor an 3V3 on the board using the ADC
2023-10-09 Change: added adc function to seperate files
2023-10-09 Change: added the sampling of the sensor
2023-10-10 Docs: updated documentation of the sensor register functions
2023-10-11 Add: enable i2c listen and change sample register size to uint8_t
2023-10-12 Fix: fixed crc order
    [I2C_Slave.c]
2023-10-17 Change: use the external crystal for better power consumption and fixed the naming of GPIO
    [P22296-2-SW.ioc, main.c, main.h, modbus.c, modbus.h]
2023-10-19 Add: added functionality for requesting data of a specific sensor
2023-10-20 Add: add slave address dependent on the slot id
2023-10-20 Fix: fixed priorities of the interrups. I2C would NACK messages because it was halted by another interrupt.
    [P22296-2-SW.ioc]
2023-10-20 Change: generated files based on changing the interrupt priorities
2023-10-25 Add: added functions to enable the specific sensors
2023-11-06 Change: Changed slot gpio to default input
2023-11-06 Change: turn on debug led on start
2023-11-08 Add: added function to get both pressure and temperature in one request. Only a float can be read out in this method. Need to change the sensor data register type to contain a float.
2023-11-08 Add: added check on timeout of the uart function and return zero when there is no message received
2023-11-08 Add: added conditional check that if sensor is not found during the init , it will not sample this sensor to save time
2023-11-09 Fix: Fixed slot id calculation
    [main.c]
2023-11-10 Change: changed debug configuration to debug te MFM sensor and MFM basis simultaneously
2023-11-10 Add: added one wire external interrupts
2023-11-10 Add: added function to determine the sensor type
2023-11-10 Add: added second case for the polling the one wire sensors
2023-11-10 Change: enable both timers for the huba sensors
2023-11-13 Change: use timer input capture instead of GPIO EXTI and increased the frequency because measurement are in us and 8Mhz is not sufficient
2023-11-13 Add: added callback with implementation for the Huba sensor. Buffer needs to converted to bytes for the pressure and temperature data.
2023-11-13 Add: added the huba sensor implementation in the switch case. There is still a timing issue with reading the sensor. it needs a lot of samples to get 10 samples.
    [Keller.c, Keller.h, SensorRegister.c, SensorRegister.h, main.c]
2023-11-13 Change: changed direction because this was inverted because of the timing issue
    [main.c]
2023-11-13 Fix: fixed the timing issue by adding a delay because the transistion of the pull-up was included in the sampling of the sensor. This caused the data to be offset. This made it that the sensor needed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
    [main.c]
2023-11-14 Docs: added comments to the timer callback
2023-11-14 Change: added struct with all variables needed for one huba sensor measurement so another can be easily added.
2023-11-14 Change: fixed the callback to determine the right sensor based on the used timer handle
    [main.c]
2023-11-14 Add: enable interrupts for timer 21
2023-11-14 Change: test the second sensor with timer 21 and used a different pin because pin PB4 can not be used for timer21 input capture
2023-11-14 Change: enable both sensor timers
2024-01-04 Change: changed clock source to internal because external clock is not soldered standard
2024-01-05 Add: added address assign case. Needs to be called by the MFM basis.
2024-01-10 Fix: fixed software for using both keller sensor simultaeously
    [Keller.c, utils.c]
2024-01-11 Fix: fixed huba sensor and can read out both sensors. Not simultaneously!!
    [P22296-2-SW.ioc, main.c, utils.c]
2024-01-11 Set clock configuration for keller sensor as default. Need to make a function to scale up the frequency for the one wire sensor
2024-01-11 Add: added different clock config based on print variant
2024-01-11 Removed debug code so that it functions correctly when connected to the MFM Basis
    [SensorRegister.h, main.c]
2024-01-23 Increased clock frequency to respond faster to i2c communication
2024-01-26 Add: added a error situation if a wrong register address is received
    [I2C_Slave.c, SensorRegister.c]
2024-01-31 change: partly revert e5dae98bca630b00a4cbd3060ac6d85b06e76f98, I2C SCL keeps low after previous commit. Guard regIndex from negative to proceed.
    [I2C_Slave.c, SensorRegister.c]
2024-02-01 Revert "change: all experiments test code."
    This reverts commit 5e287e3ed2d45bf1b4aa905188f28e027bb2b350.
    [I2C_Slave.c, main.c]
2024-02-01 change: fix problem with hanging SCL line on low level. Only disable the I2C solves it.
    [I2C_Slave.c, I2C_Slave.h, main.c]
2024-02-14 change: add new registers for sensor init
2024-02-14 change: add new functions for sensor init
2024-02-14 change: check on active commando sensor init. Rewrite to make sure only one command can be active at the time. Prio to: 1. writeflag, 2. init, 3. measure
2024-02-14 change: enable init function for RS485 sensor (keller) only
2024-02-14 change: rewrite sensor enable functions.
2024-02-14 change: add function for switch buckConverter.
2024-02-14 change: add function to switch on the keller sensors.
2024-02-14 change: add also delay after sensor 2.
2024-02-14 change: move enable sensor1 to measure function, more logical to keep it together.
2024-02-14 change: sensor enable signal is inverted.
    [utils.c]
2024-02-22 change: add function to send data directly to modbus uart.
2024-02-22 change: use new function for data sending to modbus uart.
2024-02-22 change: add workaround for Keller sensor, send first a dummy byte 0xFF with a delay after it. This helps to get the Keller sensor in the right receive state.
    [utils.c]
2024-02-26 change: disable sensor after init sensor 1 for Keller.
2024-02-26 change: add function to check if baudrate of sensor is valid.
2024-02-26 change: add function to assign sensor addres, also checks baudrate and set it to default 115200
2024-02-26 change: add function to check errors.
    [Keller.c]
2024-02-26 change: move function to skipp warning
    [Keller.c]
2024-02-26 change: add error result for failed senorInit
    [SensorRegister.c, SensorRegister.h, main.c, utils.c, utils.h]
2024-02-26 fix: must be 0xF0 and nog 0x0F for error.
    [SensorRegister.c]
2024-02-26 change: Failure must be 0x0F, not 0xF0. 0xF0 is command error at master side.
    [SensorRegister.c]
2024-02-26 change: temporary set sensors to 9600.
2024-02-26 Revert "change: temporary set sensors to 9600."
    This reverts commit d27b2d4f5218d46024ee9ebeac63605128027bc2.
    [modbus.h, utils.c]
2024-02-27 change: setup sensor measure time based on type of sensor.
2024-02-27 Revert "change: add testcode for toggle GPIO for sleep"
    This reverts commit 7ae74dcc3788a9033f484dd065fdaaeeba058c18.
    [main.c]
2024-02-27 change: remove enter sleep. This cause sometimes an much longer ON time.
    For current consumption sleepmode is not realy needed.
    Open source development can improve this in future.
2024-03-05 change: rename sensorinit function
2024-03-05 change: add function to get the selected sensor
2024-03-05 change: add sensorinit function for each sensor separately.
2024-03-05 change: use new function for separatly execute the init for each sensor channel.
2024-03-05 change: temporary enable pin for toggle
2024-03-05 change: add return uart status.
2024-03-05 change: disable functional "SystemClock_Config()" to prevent placing it outside "usercode" section.
    [P22296-2-SW.ioc]
2024-03-05 change: cubeMxFile enable uart DMA
2024-03-05 change: code generation of enable DMA for uart.
2024-03-05 Revert "change: temporary add some debug code."
    This reverts commit fbecd9852c5146edcb44f3f1132b837dd622e1cc.
    [Keller.c, main.c, modbus.c]
2024-03-05 change: use uart DMA RX function
2024-03-05 change: make new typedef for return error value.
    [modbus.c, modbus.h]
2024-03-05 Change: handle all modbusTransmit/ModbusReceive errors.
    [Keller.c]
2024-03-05 Revert "change: temporary enable pin for toggle"
    This reverts commit fd73dfb172df82ac7c8e5f95cb1382c5d0ea1517.
    [main.c]
2024-03-06 change: use function to clear measurement data and only save data when sensor is read.
2024-03-06 change: use define for number of sensor
2024-03-06 change: also for onewire sensors (huba) make sure only valid value is stored.
2024-03-06 change: add function to minimize and maximaze the number of samples.
2024-03-06 change: use getNumberOfSamples() to guard min/max of number of samples.
2024-03-06 change: at missing function comment.
    [utils.c]
2024-03-06 change: add change Callback function for receiving new number of samples, update measure time.
2024-03-06 change: fix, use sensorNr, not 0.
    [utils.c]
2024-03-06 change: use local variable to detect if sensor is available. State .hubaDone is only for new measure.
2024-03-06 change: fix on commit beda028d36a81ea9727f1c84156a4b3fd58f9467
    [SensorRegister.c]
2024-03-07 change: add typdef for struct sensor data HUBA.
2024-03-07 change: add union typedef sensor data.
2024-03-07 change: use uint16 in sensordata.
2024-03-07 change: for Huba use real sensor data.
2024-03-07 change: add function to change dataSize for different sensor
2024-03-07 change: set datasize at powerup
2024-03-07 change: fix must be union
    [SensorRegister.h]
2024-03-07 change: fix use huba store
    [utils.c]
2024-03-07 change: correct mistake also check on ONE_WIRE.
    [SensorRegister.c]
2024-03-12 change: add some missing doxygen headers
    [adc.c, crc16.c]
2024-03-12 change: correct some doxygen warnings.
    [SensorRegister.c]
2024-03-12 change: add missing doxygen comments.
    [Huba.c, Huba.h, I2C_Slave.c, Keller.c, SensorRegister.c, SensorRegister.h, adc.c, main.c]
2024-06-12 Set SLOT_GPIO as outputs
2024-06-18 Added callback function for changing the pin directions
2024-06-18 Revert "Changed based on cube mx change"
    This reverts commit b2295d5b137e15ac9e2e5c41f35b9e515659a7f9.
    [main.c]
2024-06-18 Revert "Set SLOT_GPIO as outputs"
    This reverts commit fa1994c519674bcccbcb51064377e6bffb83f164.
    [P22296-2-SW.ioc]
2024-06-18 Fixed wrong register address
    [SensorRegister.c]
2024-06-19 Fixed GPIO direction change functions
    [SensorRegister.c]
2024-06-19 Added check on power supplies and write to the error code register for the production test to check
    [SensorRegister.c, SensorRegister.h, main.c, utils.c]
2024-06-19 Fixed starting adc measurement when sensors are activated
    [utils.c]
2024-06-20 Disabled DMA
2024-06-20 Cube mx disable DMA and only use ADC input 6
2024-06-20 Changed to only on adc channel to measure the Vsensor voltage.
2024-06-20 Added error code for I2C fault
    [main.c]
2024-06-20 Fixed ADC measurement
2024-07-10 Changed to 0.6A because optimatisation caused the adc measurement to fail in the production test
    [SensorRegister.h]
2024-10-22 Added gpio on PB11 for switching the p-fet
2024-10-22 Added gpio write to enable the p-fet just before enabling the sensor fets
2024-10-22 Added minum 25ms wait time for stabilizing the output voltage of the buck/boost
2024-10-22 Added function for swicthing the current limit resistor
2024-10-22 Put reenableing of current limit just before switching off the buck/boost
2024-11-05 Set sensor enable outputs as open drain
2024-11-05 Removed VCC test because it interferes with the measurement of the Vsensor and causes the production test to fail falsely.
    [main.c]
2024-11-05 Revert "Removed VCC test because it interferes with the measurement of the Vsensor and causes the production test to fail falsely."
    This reverts commit ceeb09a2085cafbd5933a3020f3338ffc6494d22.
    [main.c]
2024-11-05 Added a deinit after cubemx init to prevent the adc from not working
    [main.c]
2024-11-07 Disable channel in cubemx init. When 2 different ranks are set the adc does not correctly switch between channels.
    [main.c]
2024-11-08 Changed meas time calculation to include startup time of de buck/boost and sensor communication. Made sure that time calculation included two sensors. Not changed for RS485 because this sensor does n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
2025-05-08 Upload hardware files and docs
    [Frontpage.SchDoc, MCU.SchDoc, Mechanical.SchDoc, P22296-2-DES.PrjPcb, Power.SchDoc, Sensor Interface.SchDoc]
